radensb/TAZ6-Archim2-Conversion/Archim2ConversionBOM_TAZ6.xlsx

Index | Quantity | Part Number | Manufacturer Part Number | Description | Use
1 | 1 | WM2902-ND | 0050579404 | CONN HOUSING 4POS .100 W/LATCH | Aux Power connector for 5V to extruder heat break fan
2 | 50 | WM2510CT-ND | 0016020086 | CONN SOCKET 22-24AWG CRIMP TIN | Female crimps for limit switch extensions and Aux power
3 | 50 | WM2517CT-ND | 0016020107 | CONN PIN 22-24AWG CRIMP TIN | Male crimps for limit switch extensions
4 | 6 | WM2901-ND | 0050579403 | CONN HOUSING 3POS .100 W/LATCH | Female connector for limit switch extensions
5 | 6 | WM2534-ND | 0701070002 | CONN HOUSING MALE 3POS .100 | Male connector for limit switch extensions
6 | 1 | 23-0022552241-ND | 0022552241 | CONN HOUSING 24POS .100 DUAL | GPIO connector housing block
7 | 50 | WM14366CT-ND | 0700580086 | CONN SOCKET 22-24AWG CRIMP TIN | Crimps for GPIO housing block
9 | 1 | 277-5963-ND | 1826283 | TERM BLOCK PLUG 2POS 5.08MM | 45 deg terminal plug to clear exhaust fan
10 | 2 | WM2533-ND | 701070001 | CONN HOUSING MALE 2POS .100 | Male connector for 5V AUZ power to hearbreak fans
11 | 1 | WM50032-24-ND | 22284242 | CONN HEADER VERT 24POS 2.54MM | Header pins to connect to bed level probe harness
