radensb/TAZ6-Archim2-Conversion/Archim2_heatsink_mount_modified_TAZ6.stl

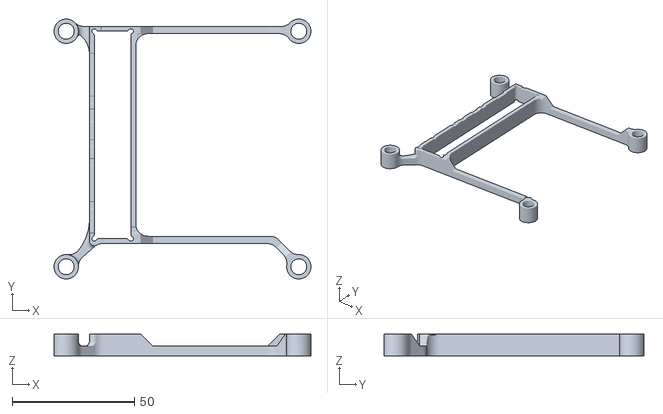
[picture p1: CAD file, 2020-01-20]
Archim2_heatsink_mount_modified_TAZ6.stl
105.3 x 106.5 x 9.00
