radensb/TAZ6-Archim2-Conversion/Archim2_heatsink_mount_stock_TAZ6.stl

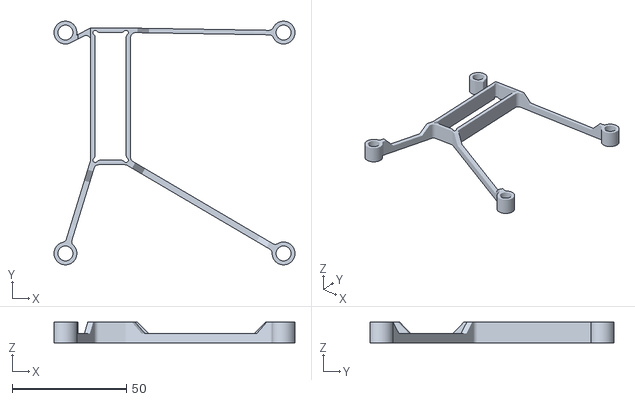
[picture p2: CAD file, 2020-01-19]
Archim2_heatsink_mount_stock_TAZ6.stl
105.3 x 106.5 x 9.00
