radensb/TAZ6-Archim2-Conversion/(threads)

Thread 1 (2020-03-29):

If using Drunken Octopus, bed washers pins should be 20

marciot, 2020-03-29:
The stock TAZ 6 firmware uses the SERVO0_PIN for the bed washers. When making drunken-octopus, I carried over the same assumption to the Archim 2.0. This means that the bed washers actually need to be connected to pin 20 rather than pin 19. Maybe it makes sense to add an annotation to that effect to the document as to not confuse people who are looking for pre-compiled firmware?

Here is what the header needs to look like if using Drunken Octopus:

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

radensb, 2020-03-31:
Thanks for pointing that out Marcio. I agree. I just chose that pin at random for my rig, but it makes sense to me to change it for cross platform compatibility.

Thread 2 (2020-07-13):

Thermal Blocks

joedevivo, 2020-07-13:
Thanks for this guide. I just upgraded my TAZ 6 to the Archim2, and after some trial and error, I have everthing working, but there's still something unresolved.

The thermal blocks on my Archim2 are set up as Heat0, Heat1, Heat2, Fan0, HeatedBed. The RAMBo was set up for Heat0, Fan0, Heat1, Fan1, Heated Bed, which is how the photos in your guide look.

Since I only have one extruder, I just didn't hook up Heat1, mostly because I have no idea where to put Fan1. Except that there is a Fan1, but that's the exhaust fan.

How do you have it wired?

radensb, 2020-07-15:
It's a bit confusing as the naming does not match 1:1. Also, Lulzbot does not use both RAMBo Fan0 and Fan1 simultaneously and the active fan changes based on what toolhead is installed (single vs dual).

### **Archim2 naming used below unless otherwise specified.**
Below is the schematic for the Archim2. All the thermal block circuits are the same. The only difference is that Fan0 and Fan1 circuits use a different FET to switch power. The Lulzbot configuration is just using the Heat1 circuit to run a fan. So, the mapping looks like:

**Archim2   ->   RAMBo**

- Heat0    ->   Heat0
- Heat1    ->   Fan0 (part cooling fans on single extruder)
- Heat2    ->   Heat1
- Fan0      ->   Fan1 (part cooling fans on dual extruder)
- Bed       ->   Bed

Again, with respect to the Archim2 naming, my configuration utilizes Fan1 (the separate, 2-pin connector below and to the left of the thermal block) to run the enclosure exhaust fan, and Fan0 to run the part cooling fans on the toolhead **(I have a dual extruder toolhead)**. The single extruder toolhead uses Heat1 for the part cooling fans.

- With the Lulzbot single extruder, Archim2's Heat1 (RAMBo Fan0) controls the part cooling fans (and RAMBo Fan1 is unused).
- With the Lulzbot Dual v3 (what I am currently running), the Archim2's Fan0 (RAMBo Fan1) controls the part cooling fans (and RAMBo Fan0 is unused).

**Additional info::**
With a dual extruder, it get even more fun because the way Lulzbot defined the wiring, the heaters also change between toolheads because the single extruder wiring harness connects to E2 on a dual:

(Archim2 Naming Used)
**Single**
- Heat0 -> E1
- Heat1 -> Part Cooling Fans
- Heat2 -> unused
- Fan0 -> unused
- Bed -> Bed

**Dual**
- Heat0 -> E2
- Heat1 -> unused
- Heat2 -> E1
- Fan0 -> Part Cooling Fans
- Bed -> Bed

They couldn't even keep the extruder numbers zero indexed... Why Lulzbot? ...Why?

**Archim2 Thermal Block Schematic**
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

joedevivo, 2020-07-15:
Ha! If I had a nickel for every time I asked "Why Lulzbot?" :D

I think I'm following. Can you point me at how you have your firmware configured?

radensb, 2020-07-17:
I am running the [Klipper firmware](https://www.klipper3d.org/). It is a very interesting project that I find works exceptionally well. If you already know about it, you can skip the rest. :)

Instead of the printer controller board parsing ascii gcode and generating movement instructions, the gcode is parsed and processed on a much faster machine (Raspberry Pi) with kinematic models applied for very smooth operation. The Pi then sends optimized instructions to the printers controller board (the Archim2 in this case) that simply preforms the movement and reports the temps, etc. Octoprint is the user interface of choice via a plugin.

This may seem like a waste of a 32-bit board as all the brains are moved into the Pi, but the combination of silent drives, native USB, and a ton more internal resources (like RAM) allow the printer to run very fast and smooth. My old RAMBo board could not keep up with Klipper. The 8-bit MCU and USB-Serial converter just didnt have it in her. The near plug-n-play Archim2 solved that.

Also, Klipper is extremely simple to configure and customize. Everything is defined in a config file and adding peripherals (like servos, BLTouch, lights, fans, heaters, etc) just require defining the new item and what pins it is interfaced on. There is a generic config file on the Klipper Github for the Archim2. I plan to commit my TAZ6 version soon, but the basics to get going are already in the generic one. The down side is it is mainly implemented in Python. I suck at Python. Good'ol Marlin was C++ - which I have been coding in for 20 years... Unfortunately, large parts of Marlin is a dumpster fire.

joedevivo, 2020-07-20:
I've tried klipper, but when I successfully flash the firmware the Archim2 lets out a whine, which it always does on a firmware flash, but when I turn it off and on, nothing comes on the screen and the whine starts again, and keeps going... forever. That ever happen to you?

radensb, 2020-07-21:
Cant say I recall a "whine", but the screen will stay blank if your config file was rejected due to misconfiguration (syntax). What creates the whine noise? I dont think there is a speaker on that board... :)

I have included a snippet of my config file that should get you up and running. Use it to compare with your config file. I disabled some advanced features like pressure advance and my BLTouch probe, so there is no probe support. However, it should get the machine moving. Please check for:

- *** VERIFY/UPDATE FOR SINGLE ***
- *** VERIFY FOR SINGLE ***

notes as these may need to be adjusted for a single extruder before trying to home the machine.
[Klipper_TAZ6_BasicCgf.cfg.txt](https://github.com/radensb/TAZ6-Archim2-Conversion/files/4951029/Klipper_TAZ6_BasicCgf.cfg.txt)

joedevivo, 2020-07-24:
I'll take another crack at this over the weekend. Would you mind sharing your `klipper/.config`?

vitormhenrique, 2020-11-30:
hello @radensb I'm looking foward to do this upgrade on my taz 6, would you mind sharing tour `.config` file?
Amazing project and documentation!
Thank you very much!

Closed 2024-01-02.

Thread 3 (2022-09-22):

Modified mount heatsink size

timkent, 2022-09-22:
Thanks for your research and documentation here, it is super useful!

I've printed the modified mount and I'm going to machine a new heatsink. It looks like your mounting bracket accommodates a heatsink that is 85x15mm, is that correct? You mentioned that the other dimensions are the same as the unmodified heatsink, so I was going to make something 85x13mm, but this would leave a 1mm gap above and below the heatsink in the mounting bracket (I'm not talking about thickness here, you have covered that pretty well).

If you have made yours 85x15mm then I'll do the same, I just didn't want to find out later that I'd made a mistake and it is touching components on the underside of the board.

Cheers

radensb, 2022-10-01:
@timkent, the heatsink I made for this was longer because the original one didn't seem to span long enough to properly contact the board under the last stepper driver. Since I was planning to dual extruder setup, I wanted to make sure that both extruder drivers had proper thermal considerations. The mounting bracket was designed to fit without interfering with anything on the bottom of the board. There are even some slots in the mount that clear features on the bottom. Keep in mind, that is for the current 2.2b version of the board (which is what I got back in 2019 and believe is the same revision that they currently sell even though the Ultimaker site shows a pic with a 2.1a board...).

Hope that helps!

timkent, 2022-10-06:
Thanks @radensb, I was specifically talking about the 13mm vs 15mm dimension, it looks like the original brace is also slightly smaller in width? (not just length)

When I first asked the question my Archim2 board had not yet arrived but I now have it here and can see that the wider 15mm heatsink will clear the components without issue.

Thank you so much for documenting the process!

radensb, 2022-10-06:
AH, yes - sorry. Its been so long, I forgot about that! You are the first one to bring this up and point out that inconsistency in the text. The simple reason was to be compatible with the thermal pad out of the box. Notice that the thermal pad strip I bought was 100mmx15mm. I was worried that it would be a pain to trim off 2mm of the pad down the long side of the pad cleanly and just widened the heatsink to match it. I figured that a bit extra thermal mass couldn't hurt and I still cleared all areas on the bottom of the board. I should update the text to indicate that dimensional change too!
