radensb/TAZ6-Archim2-Conversion/(commit log)

2020-01-20 Corrected scale of modified heatsink mount. Added extension lengths. Added info on heatsink bar height calculation and thermal pad compression. Updated PDF. Fixed typos.
    [Archim2_heatsink_mount_modified_TAZ6.stl]
2020-02-05 Updated Guide: - Added some images of heatsink mount installation. - Alternative heatsinking section. - Additional details in thermal pad installation.
2020-03-31 Updated to v1.3. - Added notes for Drunken Octopus Firmware regarding different bed washer probe pin.
